ednieuw/Fibonacci-Vierkantekokerklok/(commit log)

2019-12-11 Add files via upload
    PDF van de webpagina
2020-01-31 Added HC-12 433MHz Long Range Wireless Communication Module
2020-01-31 Handleiding vna de Fibbonacci-stokklok
    Uitgebreide handleiding en beschrijving van de software om de klok zelf te maken
2020-01-31 Oude handleiding. Vervangen door een nieuwe
2021-03-10 V021
    V005 In Fibonacciklok No 5&6
    V006 Derived from VierkantbuisklokV005. Rotary added, Keypad wirh 7 pins and for One-wire keypad. Menu changed
    V007 Release version in Fibonacci-klok No7
    V008 Optimized HC-12 receiver code from: https://forum.arduino.cc/index.php?topic=396450.0
    V009 Changed time input. Only 6 digits allowed in format hhmmss. T124500 for time entry in menu added
    V010 Added coding for the stick clock that uses no PCB
    V011 Changed palettes P0-P9 and colours in it. Corrected BT pinnumbers. corrected initialisation: int Previous_LDR_read = 51 --> 512;
    V012 Palette stored in EEPROM. Darkgray in palette choices added
    V013 Removed Secpulse and simplified Brightness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
2021-04-16 FABLAB and SK6812 lib. Use of DS3231 NVRAM
    V024 Added One wire 3x1 membrane button ONEWIREKEYPAD3x1
    V025 Store 24 bytes of the last 24 hour LDR readings to DS3231 NVRAM
    Corrected rotary encoder bug in processing key press looping forever
    V026 In Fibonacci clocks with 13 WS2812 LEDs
    V027 Added two SK6812 libraries FAB LED and Arduino-SK6812 instead of Ada Neopixel that corrupts memory in a Arduino Nano with this program size
    Removed compiler warnings when set to 'all'in preferences
    V028 Changed constrain(mem,0,250) -->= min(mem,250)
    [FibonacciKlok_V028.ino]
